MetehanQF/rescue-robot-car/hardware/battery-pack/photos/pack-top.jpeg

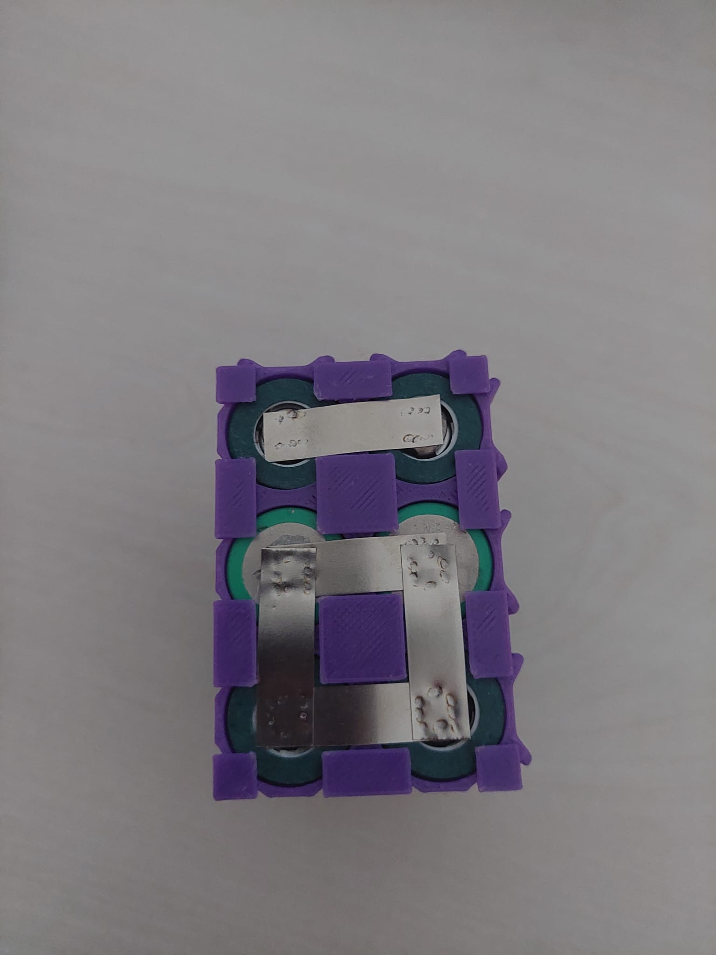
hardware/battery-pack/photos/pack-top.jpeg
