MetehanQF/rescue-robot-car/hardware/battery-pack/photos/pack-bottom.jpeg

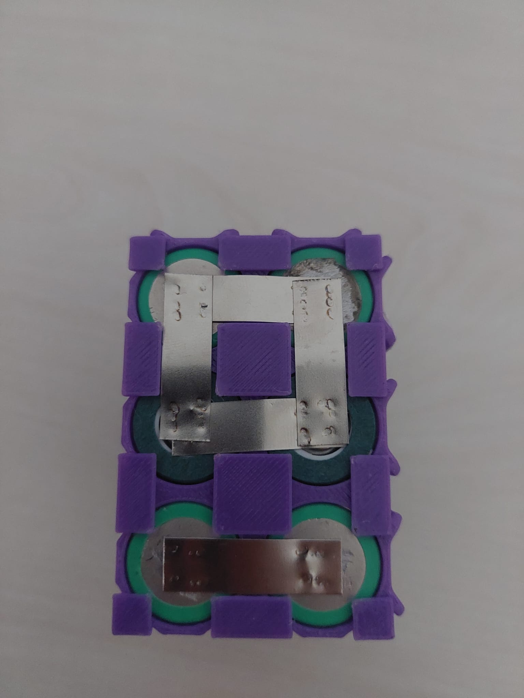
hardware/battery-pack/photos/pack-bottom.jpeg
