MetehanQF/rescue-robot-car/hardware/battery-pack/battery-3s2p-configuration.png

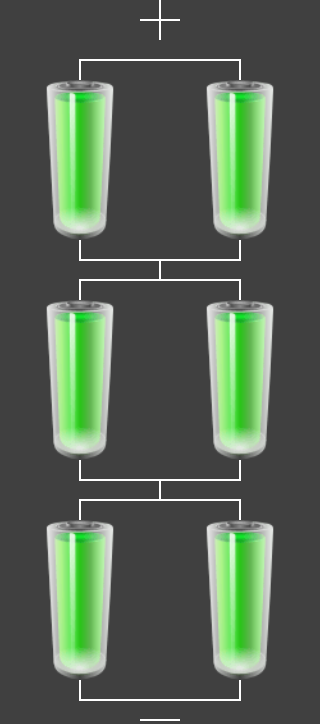
hardware/battery-pack/battery-3s2p-configuration.png
