MetehanQF/rescue-robot-car/hardware/battery-pack/photos/pake-angle.jpeg

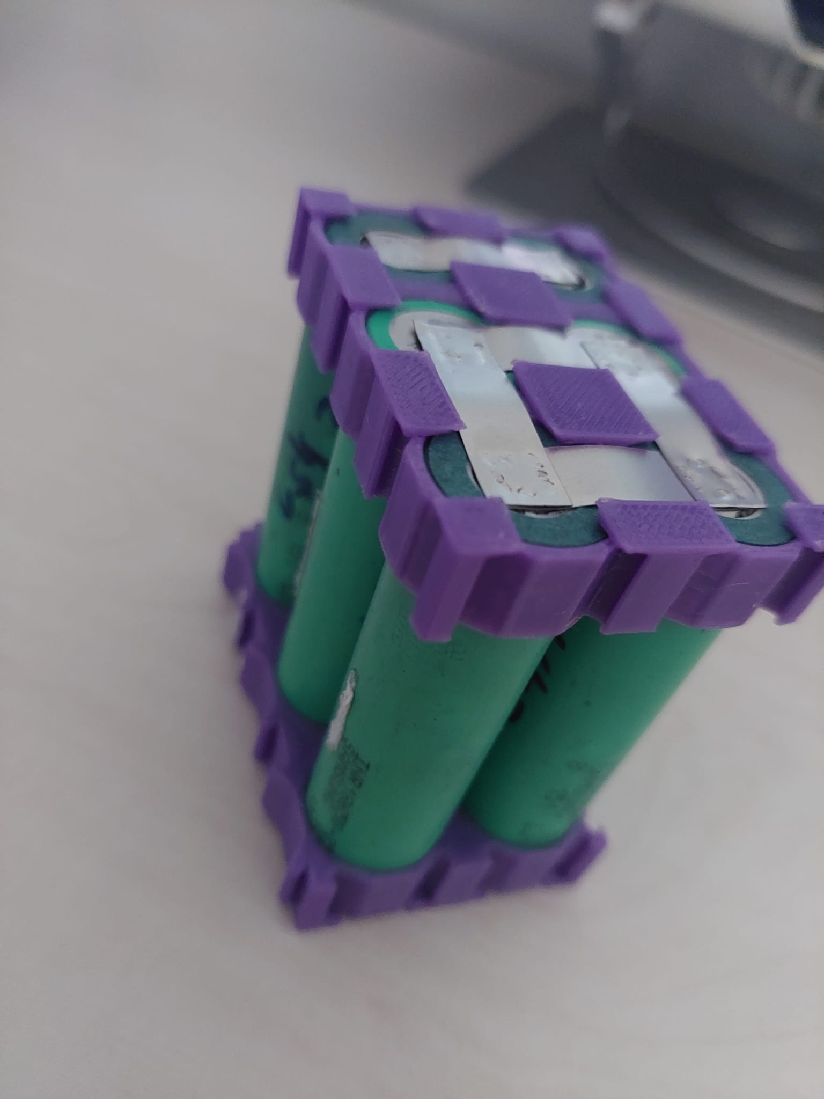
hardware/battery-pack/photos/pake-angle.jpeg
