MetehanQF/rescue-robot-car/firmware/stm32/Core/Src/main.c

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
/* Includes ------------------------------------------------------------------*/
#include "main.h"
#include "usb_host.h"

/* USER CODE BEGIN Includes */

#include <stdio.h>
#include <stdlib.h>
#include <string.h>

uint8_t rxData;         // One byte received from UART
char rxBuffer[20];      // Buffer for received joystick data
uint8_t rxIndex = 0;    // Buffer index

volatile int joystick_x = 2048;     // Default joystick X center value
volatile int joystick_y = 2048;     // Default joystick Y center value
volatile uint8_t newData = 0;       // New UART data flag

#define PWM_MAX     4200            // Maximum PWM value
#define ADC_CENTER  2048            // Center value of joystick ADC
#define DEADZONE    500             // Joystick deadzone range

int left_speed = 0;                 // Left motor speed value
int right_speed = 0;                // Right motor speed value

void HCSR04_Trigger(void);          // Function prototype for ultrasonic trigger
void delay_us(uint32_t us);         // Function prototype for microsecond delay

volatile uint32_t ic_rising = 0;    // Timer value at rising edge
volatile uint32_t ic_falling = 0;   // Timer value at falling edge
volatile uint32_t echo_us = 0;      // Echo pulse duration in microseconds
volatile uint8_t is_first_capture = 0; // Capture state flag
volatile uint8_t distance_ready = 0;   // Distance measurement ready flag
uint32_t last_trigger_time = 0;        // Last trigger time

uint32_t distance_cm = 0;           // Distance value in centimeters
uint32_t dacValue = 0;              // DAC output value
uint32_t echoTime = 0;              // Echo time variable

/* USER CODE END Includes */

DAC_HandleTypeDef hdac;

SPI_HandleTypeDef hspi1;

TIM_HandleTypeDef htim2;
TIM_HandleTypeDef htim3;

UART_HandleTypeDef huart2;

void SystemClock_Config(void);
static void MX_GPIO_Init(void);
static void MX_SPI1_Init(void);
static void MX_TIM3_Init(void);
static void MX_USART2_UART_Init(void);
static void MX_TIM2_Init(void);
static void MX_DAC_Init(void);
void MX_USB_HOST_Process(void);

/* USER CODE BEGIN 0 */
int limit_pwm(int value)
{
    if (value > PWM_MAX) return PWM_MAX;   // Limit positive PWM value
    if (value < -PWM_MAX) return -PWM_MAX; // Limit negative PWM value
    return value;                          // Return safe PWM value
}

int joystick_to_pwm(int adc_value)
{
    int centered = adc_value - ADC_CENTER; // Convert ADC value around center

    if (centered > -DEADZONE && centered < DEADZONE)
    {
        return 0;                          // Stop motor inside deadzone
    }

    if (centered > 0)
    {
        return (centered * PWM_MAX) / (4095 - ADC_CENTER); // Convert positive joystick value to PWM
    }
    else
    {
        return (centered * PWM_MAX) / ADC_CENTER;          // Convert negative joystick value to PWM
    }
}

void Motor_Left_SetSpeed(int speed)
{
    speed = limit_pwm(speed);              // Limit motor speed value

    if (speed > 0)
    {
        __HAL_TIM_SET_COMPARE(&htim3, TIM_CHANNEL_1, speed); // Left motor forward PWM
        __HAL_TIM_SET_COMPARE(&htim3, TIM_CHANNEL_2, 0);     // Reverse PWM off
    }
    else if (speed < 0)
    {
        __HAL_TIM_SET_COMPARE(&htim3, TIM_CHANNEL_1, 0);      // Forward PWM off
        __HAL_TIM_SET_COMPARE(&htim3, TIM_CHANNEL_2, -speed); // Left motor reverse PWM
    }
    else
    {
        __HAL_TIM_SET_COMPARE(&htim3, TIM_CHANNEL_1, 0);      // Stop forward PWM
        __HAL_TIM_SET_COMPARE(&htim3, TIM_CHANNEL_2, 0);      // Stop reverse PWM
    }
}

void Motor_Right_SetSpeed(int speed)
{
    speed = limit_pwm(speed);              // Limit motor speed value

    if (speed > 0)
    {
        __HAL_TIM_SET_COMPARE(&htim3, TIM_CHANNEL_3, speed); // Right motor forward PWM
        __HAL_TIM_SET_COMPARE(&htim3, TIM_CHANNEL_4, 0);     // Reverse PWM off
    }
    else if (speed < 0)
    {
        __HAL_TIM_SET_COMPARE(&htim3, TIM_CHANNEL_3, 0);      // Forward PWM off
        __HAL_TIM_SET_COMPARE(&htim3, TIM_CHANNEL_4, -speed); // Right motor reverse PWM
    }
    else
    {
        __HAL_TIM_SET_COMPARE(&htim3, TIM_CHANNEL_3, 0);      // Stop forward PWM
        __HAL_TIM_SET_COMPARE(&htim3, TIM_CHANNEL_4, 0);      // Stop reverse PWM
    }
}

void Motor_Stop(void)
{
    Motor_Left_SetSpeed(0);       // Stop left motor
    Motor_Right_SetSpeed(0);      // Stop right motor
}

void drive_from_uart_joystick(void)
{
    int x = joystick_x;           // Read joystick X value
    int y = joystick_y;           // Read joystick Y value

    int forward = joystick_to_pwm(y); // Convert Y axis to forward/backward PWM
    int turn    = joystick_to_pwm(x); // Convert X axis to turning PWM

    left_speed = 0;               // Reset left speed
    right_speed = 0;              // Reset right speed

    if (forward != 0)
    {
        left_speed = forward;     // Move left motor forward/backward
        right_speed = forward;    // Move right motor forward/backward
    }
    else
    {
        if (turn > 0)
        {
            left_speed = turn;    // Turn right by driving left motor
            right_speed = 0;      // Keep right motor stopped
        }
        else if (turn < 0)
        {
            left_speed = 0;       // Keep left motor stopped
            right_speed = -turn;  // Turn left by driving right motor
        }
        else
        {
            left_speed = 0;       // Stop left motor
            right_speed = 0;      // Stop right motor
        }
    }

    left_speed = limit_pwm(left_speed);     // Limit left motor PWM
    right_speed = limit_pwm(right_speed);   // Limit right motor PWM

    Motor_Left_SetSpeed(left_speed);        // Apply left motor speed
    Motor_Right_SetSpeed(right_speed);      // Apply right motor speed
}



void delay_us(uint32_t us)
{
    uint32_t start = __HAL_TIM_GET_COUNTER(&htim2); // Get current timer value

    while ((__HAL_TIM_GET_COUNTER(&htim2) - start) < us); // Wait for given microseconds
}

void HCSR04_Trigger(void)
{
    HAL_GPIO_WritePin(GPIOA, GPIO_PIN_1, GPIO_PIN_RESET); // Set trigger pin low
    delay_us(2);                                          // Wait 2 us

    HAL_GPIO_WritePin(GPIOA, GPIO_PIN_1, GPIO_PIN_SET);   // Set trigger pin high
    delay_us(10);                                         // Send 10 us trigger pulse

    HAL_GPIO_WritePin(GPIOA, GPIO_PIN_1, GPIO_PIN_RESET); // Set trigger pin low again
}
/* USER CODE END 0 */

/**
  * @brief  The application entry point.
  * @retval int
  */
int main(void)
{

  /* MCU Configuration--------------------------------------------------------*/

  /* Reset of all peripherals, Initializes the Flash interface and the Systick. */
  HAL_Init();

  /* Configure the system clock */
  SystemClock_Config();

  /* Initialize all configured peripherals */
  MX_GPIO_Init();
  MX_SPI1_Init();
  MX_USB_HOST_Init();
  MX_TIM3_Init();
  MX_USART2_UART_Init();
  MX_TIM2_Init();
  MX_DAC_Init();
  /* USER CODE BEGIN 2 */
  HAL_TIM_PWM_Start(&htim3, TIM_CHANNEL_1);     // Start PWM for left motor forward
  HAL_TIM_PWM_Start(&htim3, TIM_CHANNEL_2);     // Start PWM for left motor reverse
  HAL_TIM_PWM_Start(&htim3, TIM_CHANNEL_3);     // Start PWM for right motor forward
  HAL_TIM_PWM_Start(&htim3, TIM_CHANNEL_4);     // Start PWM for right motor reverse

  HAL_TIM_IC_Start_IT(&htim2, TIM_CHANNEL_1);   // Start input capture interrupt for echo signal
  HAL_DAC_Start(&hdac, DAC_CHANNEL_1);          // Start DAC output

  Motor_Stop();                                 // Stop motors at startup

  HAL_UART_Receive_IT(&huart2, &rxData, 1);     // Start UART receive interrupt

  /* USER CODE END 2 */

  /* Infinite loop */
  /* USER CODE BEGIN WHILE */
  while (1)
  {
    /* USER CODE END WHILE */
    MX_USB_HOST_Process();

    /* USER CODE BEGIN 3 */
    drive_from_uart_joystick();               // Drive motors according to joystick data

    if (HAL_GetTick() - last_trigger_time >= 60)
        {
            last_trigger_time = HAL_GetTick();    // Update trigger time

            distance_ready = 0;                   // Clear distance ready flag
            is_first_capture = 0;                 // Reset capture state

            __HAL_TIM_SET_CAPTUREPOLARITY(&htim2, TIM_CHANNEL_1, TIM_INPUTCHANNELPOLARITY_RISING);
            // Set input capture to rising edge

            HCSR04_Trigger();                     // Send trigger pulse to ultrasonic sensor
        }

        if ((HAL_GetTick() - last_trigger_time > 35) && distance_ready == 0)
        {
            distance_cm = 100;                    // Set maximum distance if no echo is received
        }

        if (distance_cm > 100)
        {
            distance_cm = 100;                    // Limit distance to 100 cm
        }

        dacValue = 4095 - ((distance_cm * 4095) / 100);
        // Convert distance value to DAC value

        HAL_DAC_SetValue(&hdac, DAC_CHANNEL_1, DAC_ALIGN_12B_R, dacValue);
        // Write calculated value to DAC output

        HAL_Delay(5);                             // Small delay

  }
  /* USER CODE END 3 */
}

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
/* USER CODE BEGIN 4 */
void HAL_UART_RxCpltCallback(UART_HandleTypeDef *huart)
{
    if (huart->Instance == USART2)             // Check if interrupt comes from USART2
    {
        HAL_GPIO_TogglePin(GPIOD, LD4_Pin);    // Toggle LED when UART data is received

        if (rxData == '\n')                    // Check end of received data
        {
            rxBuffer[rxIndex] = '\0';          // Finish string

            sscanf(rxBuffer, "%d,%d", (int*)&joystick_x, (int*)&joystick_y);
            // Split received X,Y joystick data

            rxIndex = 0;                       // Reset buffer index
            newData = 1;                       // Set new data flag
        }
        else
        {
            if (rxIndex < sizeof(rxBuffer) - 1)
            {
                rxBuffer[rxIndex++] = rxData;  // Store received byte in buffer
            }
            else
            {
                rxIndex = 0;                   // Reset buffer if it is full
            }
        }

        HAL_UART_Receive_IT(&huart2, &rxData, 1); // Restart UART receive interrupt
    }
}



void HAL_TIM_IC_CaptureCallback(TIM_HandleTypeDef *htim)
{
    if (htim->Instance == TIM2 && htim->Channel == HAL_TIM_ACTIVE_CHANNEL_1)
    {
        if (is_first_capture == 0)
        {
            ic_rising = HAL_TIM_ReadCapturedValue(htim, TIM_CHANNEL_1);
            // Read rising edge timer value

            is_first_capture = 1;              // First edge is captured

            __HAL_TIM_SET_CAPTUREPOLARITY(htim, TIM_CHANNEL_1, TIM_INPUTCHANNELPOLARITY_FALLING);
            // Change capture polarity to falling edge
        }
        else
        {
            ic_falling = HAL_TIM_ReadCapturedValue(htim, TIM_CHANNEL_1);
            // Read falling edge timer value

            if (ic_falling >= ic_rising)
            {
                echo_us = ic_falling - ic_rising; // Calculate echo pulse time
            }
            else
            {
                echo_us = (0xFFFFFFFF - ic_rising) + ic_falling + 1;
                // Calculate pulse time if timer overflows
            }

            distance_cm = echo_us / 58;        // Convert echo time to distance in cm

            if (distance_cm > 100)
            {
                distance_cm = 100;             // Limit distance to 100 cm
            }

            distance_ready = 1;                // Distance value is ready
            is_first_capture = 0;              // Reset capture state

            __HAL_TIM_SET_CAPTUREPOLARITY(htim, TIM_CHANNEL_1, TIM_INPUTCHANNELPOLARITY_RISING);
            // Change capture polarity back to rising edge
        }
    }
}
/* USER CODE END 4 */
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
