MetehanQF/rescue-robot-car/(commit log)

2026-02-23 Add ESP32 communication layer
2026-02-23 Add STM32 motor control base
2026-02-23 Add Raspberry Pi software base
2026-03-12 Add 3S2P 18650 battery pack design
2026-03-12 Update battery-info.md
    Added protection features and components list to battery info.
2026-03-12 Add 3S2P battery pack photos
2026-06-03 Add prototype 01 bill of materials
2026-06-03 Add prototype 01 mechanical notes
2026-06-03 Add prototype 01 problems and solutions
2026-06-03 Add prototypes index
2026-06-03 Add core files of STM32
2026-06-03 Add driver files of STM32
2026-06-03 Add ioc of STM32
2026-06-03 Reorganize prototype 01 firmware folders
2026-09-27 Restructure, document, and move the controller address out of source
    The repository had two parallel trees: a top-level skeleton of fourteen
    one-line placeholder READMEs, and the real work buried under
    prototypes/prototype-01-basic-rc-car/. Anyone landing on it saw the skeleton.
    Firmware and hardware documentation now live at the top level where they are
    found, and prototypes/ keeps the per-prototype narrative — what was built,
    what broke, what that requires of the next one. Every move is a rename, so
    history follows the files: git reports 110 renames with no content change, and
    all 94 vendored driver files plus the eleven CubeMX Core files are byte
    identical to before.
    The vehicle sketc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
    [Controller_Motor.ioc, config.example.h, controller.ino, main.c, main.h, vehicle.ino]
